Lekezz/wasn_node/docs/project-writeup-gdoc.md

Github: [https://github.com/Lekezz/wasn\_node.git](https://github.com/Lekezz/wasn_node.git)  
Presentation: [summer-presentation](https://docs.google.com/presentation/d/1hLClz3m2xzYzlfiDRH_qgMvEkAQSzI8XTW7FylySOrs/edit?usp=sharing)

# Acoustic source localization on an STM32 wireless sensor node

Status as of 2026-07-30.

## 1\. What this is

A wireless acoustic sensor node that listens with four microphones and reports the bearing of a sound source. A NUCLEO-L552ZE-Q (STM32L552, Cortex-M33 at 96 MHz) samples four PDM MEMS microphones in a 9.25 cm by 9.90 cm rectangle. When a clap happens, the node measures the small differences in arrival time between microphones and turns them into a direction. Capture, cross-correlation, and the direction fit all run on the microcontroller, with a matching Python implementation kept as the reference the firmware is checked against.

The result: on an 8-angle sweep in a real room, mean absolute bearing error was **1.11 degrees**, matching what simulation of the same array predicts. The remaining error appears to come from how accurately the source was marked on the floor, not from the array.

### Summary of key numbers

| Quantity | Value |
| :---- | :---- |
| Microphones | 4 x MP34DT01-M PDM, 16 kHz PCM via DFSDM |
| Array | 9.25 cm x 9.90 cm rectangle, ruler measured to about 0.5 mm |
| Aperture (diagonal) | 13.549 cm, which is 6.32 samples of delay |
| Condition number / rank | 1.070 / 2 (no blind directions) |
| Mean absolute bearing error | 1.11 deg over 39 claps, 8 angles |
| Worst single clap | 4.04 deg |
| Trial to trial spread | 0.99 deg mean |
| Simulation on same geometry | 0.99 deg mean |
| Firmware vs Python | delays 0.000 samples, bearing within 0.004 deg, 44 captures |
| Flash, release (-O2) | 55,712 bytes of 512 KB |
| Flash / RAM, debug build | 87,904 / 217,448 bytes (256 KB RAM) |
| CMSIS-DSP FFT tables | cut from 712 KB to 44 KB |

## 2\. Hardware and capture

Each MP34DT01-M is a PDM microphone: a one bit stream at a high rate that a digital filter turns into ordinary PCM. The STM32L5's DFSDM peripheral is built for this. One 2.4 MHz clock feeds all four microphones, and a sinc3 filter with oversampling ratio 150 gives 16 kHz, 16 bit audio per channel.

**The two-wire trick:**  
The MP34DT01-M has a SEL pin choosing which half of the clock cycle it drives its data line on: SEL to ground drives while the clock is high, SEL to 3V3 while it is low. Two microphones share one data wire without colliding, so four microphones need only two data pins. That matters because the DFSDM here has exactly four channels and Nucleo pin routing is limited.

**Sample alignment.**:  
GCC-PHAT measures delays to a fraction of a sample, so one sample of channel misalignment would be a large fraction of the array's whole aperture. Filters 1, 2 and 3 are armed with a sync trigger and filter 0 is started last, so all four begin converting on the same clock edge. The four DMA buffers are then handled as one synchronized frame: the code acts only once all four transfer flags of a phase are up, and treats all four identically. No path exists by which one channel can advance a frame ahead of another.

**Clap triggering:**  
A button press arms the array, 4000 warm-up samples (0.25 s) are discarded so the microphones and filters settle, and then the first sample above a threshold becomes sample 0 of a stored one second, four channel recording. That recording is analysed either on the board or offline over UART.

## 3\. How the algorithms work

Two algorithms: one measures the delay between a pair of microphones, the other turns six such delays into a direction.

### 3.1 GCC-PHAT: measuring the delay between two microphones

**The problem:**  
Two microphones 9.25 cm apart hear the same clap at slightly different times. At 343 m/s that difference is at most 270 microseconds, which at 16 kHz is 4.3 samples. For bearing accuracy around a degree we need that delay to a small fraction of a sample. One sample corresponds to 2.14 cm of path difference, so integer sample resolution is too coarse on its own.

**Plain cross correlation, computed through the FFT:**  
The classical way to find a delay is cross correlation: slide one signal against the other and find the shift where they overlap best. Done directly this is O(n^2). Correlation in time is multiplication in frequency, so there is a shortcut: FFT both windows, multiply one by the complex conjugate of the other, inverse FFT. That is O(n log n), and for the 2048 sample window used here it is the difference between millions of operations and tens of thousands.

**Zero pad to twice the length:**  
The FFT computes circular correlation: it treats each window as wrapping from end back to start. A genuine peak near the edge of the buffer would wrap around and reappear at completely the wrong lag. Padding both windows with zeros out to at least twice their length makes the circular correlation equal the linear one over the lags we care about. The firmware uses `LOC_WINDOW_LEN = 2048` (256 samples before the onset, 1792 after) and `LOC_FFT_LEN = 2 * LOC_WINDOW_LEN = 4096` for exactly this reason. The Python does the same by asking numpy for `n = len(a) + len(b)`.

**The PHAT weighting:**  
This is what makes the method work in a real room. After forming the cross spectrum `R = A * conj(B)`, every frequency bin is divided by its own magnitude, so only phase survives: `R[k] = R[k] / (|R[k]| + 1e-12)`.

Phase is *when* and magnitude is *what*, and only *when* carries direction information. Practically, this flattens the spectrum. Without it, a loud narrow band, or a reflection that happens to reinforce one band, dominates the sum and smears or shifts the correlation peak. With it, every band votes equally on the delay and the peak stays sharp.

Dividing by magnitude also amplifies bins containing nothing but noise, since a nearly empty bin is scaled up to the same weight as one full of signal. PHAT works best on broadband impulsive sources where most bins genuinely carry the event. A clap is close to ideal; a narrowband hum or a quiet source would be much harder, and that is one of the main limits on generalising these results. The `1e-12` guard keeps a silent bin from dividing by zero and leaves it near zero, which is correct since it carries no timing.

Also each window has its mean subtracted before the FFT. DC is a large spike in the zero frequency bin, and PHAT would normalise that spike up to the same weight as everything else and let it dominate.

**Sub-sample interpolation:**  
The inverse FFT gives a correlation curve at integer intervals, but the true peak almost never lands on a sample. Both implementations fit a parabola through the peak bin and its two neighbours and take the vertex:  
  
`offset = 0.5 * (y0 - y2) / (y0 - 2*y1 + y2)`

with y0, y1, y2 the magnitudes at peak-1, peak and peak+1. The reported delay is `best_lag + offset`. Both skip the interpolation when the peak sits on the edge of the searched range, since there is no neighbour on one side, and both guard a near zero denominator. This step takes resolution from 2.14 cm to well under a centimetre. Without it, single degree accuracy on an array this small would be impossible.

**The physical search limit:**  
The delay between two microphones cannot exceed their spacing divided by the speed of sound: 4.31 samples for the 9.25 cm baseline, 6.32 for the 13.549 cm diagonal. `Geom_MaxTauSamples()` computes this per pair and the peak search runs only over lags inside that window plus a sample of margin. Anything outside is not a possible arrival and is discarded for free. In an echoey room this kills most spurious peaks, and it is the cheapest robustness measure in the pipeline.

### 3.2 The direction estimate

**Far field assumption:**  
If the source is far enough away compared to the array size, the arriving wavefront is effectively flat across the array. Distance then stops mattering and all that survives is the direction, a unit vector `u = (ux, uy)` pointing from the array toward the source.

For a plane wave, arrival times at microphones i and j satisfy

`t_j - t_i = ((pos_i - pos_j) . u) / c`

We basically  take the vector between the two microphones, project it onto the direction the sound comes from, and divide by the speed of sound. That projection is the extra distance the wave travels to reach the later microphone, and it is the shadow described above. A microphone further along `u` is closer to the source and hears the clap earlier.

Writing the dot product out makes clear what is actually being solved for:

`delay = [ (xi - xj) * ux + (yi - yj) * uy ] / c`

The microphone spacings `(xi - xj)` and `(yi - yj)` are known, because the array was measured with a ruler. The speed of sound is known. The delay was just measured by GCC-PHAT. So `ux` and `uy` are the only unknowns in the whole system, and every pair contributes one equation of the plain form `(number) * ux + (number) * uy = (number)`.

There are two unknowns and not three because the array is flat. A direction in three dimensions needs `uz` as well, and a planar array physically cannot supply it. That is the elevation limitation listed in section 8, seen from the algebra side.

**Six equations, two unknowns:**  
Four microphones give six unique pairs, so the system is 6 by 2, overdetermined by four equations. That redundancy is the point**.** Here is a trial across all six pairs, against what the geometry predicts for a source at exactly 135 degrees:

| Pair | Predicted (samples) | Measured (samples) |
| :---- | :---- | :---- |
| 0-1 | 3.05 | 2.970 |
| 0-2 | 3.27 | 3.144 |
| 0-3 | 6.32 | 6.165 |
| 1-2 | 0.21 | 0.191 |
| 1-3 | 3.27 | 3.146 |
| 2-3 | 3.05 | 3.062 |

Every pair is close but none is exact, which is what real measurements look like. If one pair's correlation peak is pulled onto the wrong lobe by a reflection, the other five outvote it and the direction barely moves. With only two pairs there would be nothing to contradict a corrupted one.

**Least squares method:**  
This is the line of best fit, applied to a direction instead of a line. Six pairs each vote for a direction and they disagree slightly, so the fit finds the single direction that disagrees least with all six at once: for each pair, take how far off it is, square it, sum the six, and minimise the total. Squaring makes large misses hurt disproportionately, so the answer avoids being badly wrong about any one pair, and it is also what makes the minimum solvable in closed form.

## 4\. Getting it onto the microcontroller

**The FFT table problem:**  
CMSIS-DSP ships tables for every FFT size it supports. Built that delivered is about 712 KB of tables on a chip with 512 KB of flash, so the project does not fit at all. The fix was a copy of only `arm_rfft_fast_f32` and its dependencies plus a `cmsis_dsp_config.h` naming only the three tables a 4096 point real FFT needs, taking the set to 44 KB. Details in `docs/CMSIS_DSP_SETUP.md`.  
**Where the memory actually is.**

| Item | Size |
| :---- | :---- |
| `recording[4][16000]` int16, one second four channels | 128,000 bytes |
| `dma_buf[4][2048]` int32 | 32,768 bytes |
| Those two together | about 96% of `.bss` |
| FFT working buffers in `.ram2` | 49,152 bytes |
| Debug flash (87,760 text \+ 144 data) | 87,904 bytes |
| Debug RAM | 217,448 bytes |
| Release flash at \-O2 | 55,712 bytes |

The three 16 KB FFT buffers live in `.ram2`, a separate 64 KB bank nothing else uses, because the main 192 KB bank is nearly full once the capture buffers are placed. They are marked NOLOAD so startup does not zero 48 KB that gets overwritten immediately.

**Where the time goes:**  
 Cycle level profiling using the Cortex-M33 DWT counter costs 932 bytes of flash and 40 bytes of RAM. Measured on hardware at 96 MHz:

| Stage | Cycles | Time | Share |
| :---- | :---- | :---- | :---- |
| `find_clap` | 8,677,046 | 90.4 ms | 22% |
| GCC-PHAT, all six pairs | 29,526,954 | 307.6 ms | 77% |
| Fit | 2,312 | 0.024 ms | 0% |
| **Total** | **38,206,623** | **398.0 ms** | **100%** |

Three things stand out. The least squares fit, which is the part that looks like the actual localization, is free: 2,312 cycles, four ten thousandths of the total. All the cost is in the signal processing that produces the six delays. GCC-PHAT dominates at 77%, which is 51.3 ms per pair, and that cost scales with the number of pairs rather than microphones. Dropping to three microphones would halve it, saving roughly 154 ms, about 39% of the total. 

One caveat that matters: this is the Debug build, compiled at \-O0. The Release build at \-O2 is 55,712 bytes and would be substantially faster, but it has not been profiled, so no speedup factor is claimed here. Treat 398 ms as an upper bound.

## 5\. Validating the port against the reference

The Python implementation came first and was verified in simulation: delay bias under 0.001 samples, angle error under 0.1 degrees on synthetic sources with known ground truth. The firmware is an independent implementation of the same math in C, using CMSIS-DSP rather than numpy, float32 rather than float64, hand rolled 2x2 normal equations rather than `lstsq`, and a histogram median rather than `np.median`.

`compare_board.py` runs both on the same recorded samples, field by field, across 44 captures. Every pair delay agrees to 0.000 samples, every bearing to within 0.004 degrees, and onset and transient peak indices are exact everywhere. That is a strong claim because the two implementations share no code, and because the Python side was independently verified against known ground truth in simulation. 

## 6\. Results from the angle sweep

8 angles at 45 degree spacing, 5 claps each, source 1.1 m from the array, array 2.1 m from the nearest wall. 39 claps passed the bench quality check and were kept.  


| Metric | Value |
| :---- | :---- |
| Mean absolute bearing error | 1.11 deg |
| Worst single clap | 4.04 deg |
| Mean trial to trial spread within an angle | 0.99 deg |
| Simulation, same geometry | 0.99 deg |

Reverberation was expected to cost several degrees over the simulation and did not. The hardware sits at the simulation's own accuracy floor, which was not the expected outcome and is the most encouraging result in the project.

**per-angle bias:**  
Per-angle mean errors run from **\-1.43 to \+0.17 degrees**, while the spread *within* each angle stays between **0.38 and 1.82 degrees**. If the array were the limit, error would scatter randomly within each angle. Instead, each angle has its own consistent offset shared by all five of its claps, which is the signature of a fixed setup error per angle: each mark was placed on the floor by hand, and every clap at that angle inherits its offset.

At 1.1 m, a 5 cm placement error is already 2.6 degrees, more than the entire measured mean. Working backwards, the marks must have been good to roughly 2 cm for the observed numbers to be possible. That is a bound on the marks, not a measurement of them, but it does establish that truth is at least as tight a constraint as the array. Repeatability is better than accuracy against the marks, so the array is probably better than 1.11 degrees and the current setup cannot prove it.

### 7\. Does the fourth microphone earn its place?

A paired comparison on the same 39 claps, dropping one channel in software and re-running the fit through the surviving triangle.

| Configuration | Mean abs error | Worst | Spread |
| :---- | :---- | :---- | :---- |
| 4 mic | 1.11 deg | 4.04 deg | 0.99 deg |
| 3 mic triangle | 1.76 deg | 7.70 deg | 0.86 deg |

  
Pooled over all four triangles and 39 claps (156 trial configurations), the paired change was **mean \+0.88 degrees, median \+0.11, worst single degradation \+7.70**.  
The gap between mean and median is the finding. The typical clap barely notices the missing microphone; a minority collapse and drag the average. Each triangle is worst along the diagonal that does not pass through the microphone it dropped, and predicted bad angles matched observed ones.

This can be explained by geometry. Spare equations over the 2 unknowns drop from 4 to 1 and the error correction of the other two pairs is degraded.

The memory savings justify it. A genuine three-microphone node, with the DFSDM channel removed, saves about  40Kb bytes of RAM. Compute overhead also scales: pairs go from 6 to 3, halving the dominant stage.

## 8\. What is not done

The single node pipeline works end to end and is validated on hardware. 

- **One room:** Every number in section 6 is from a single session in one room. Nothing tests whether 1.11 degrees survives a different environment, reverberation time, or noise floor.   
- **The array is planar, so it gives bearing in the plane only:** A source above the plane is indistinguishable from its mirror below. Elevation needs a non-planar layout such as a tetrahedron.   
- **Single node, so bearing only, not position:** Crossing bearings from two nodes gives a position fix, but that needs inter-node time synchronization, which is its own hard problem and is not started.  
- **Claps only:** A clap is the easiest possible source, broadband and impulsive, which is exactly what PHAT weighting and the trigger and window design assume. Speech or machinery would need rethinking at the trigger, the window, and probably the weighting.

## 

[image1]: <>

[image2]: <>

[image3]: <>
