Lekezz/wasn_node/mic_sims_files/captures/2026-07-29-sweep/notes.txt

session 2026-07-29-sweep
========================

[2026-07-29 17:30] port COM4, 16000 Hz, 4 mics, geometry 9.25x9.9-measured, angles 0,45,90,135,180,225,270,315, 5 trial(s) each
    wall 2.1 m, clap 1.1 m
