Lekezz/wasn_node/mic_test/Core/Src/main.c

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
/* Includes ------------------------------------------------------------------*/
#include "main.h"

/* USER CODE BEGIN Includes */
#include "capture.h"
#include "localize.h"
/* USER CODE END Includes */

/* USER CODE BEGIN PD */
/* Capture configuration and buffers now live in capture.c / capture.h. */
/* USER CODE END PD */


COM_InitTypeDef BspCOMInit;
__IO uint32_t BspButtonState = BUTTON_RELEASED;
DFSDM_Filter_HandleTypeDef hdfsdm1_filter0;
DFSDM_Filter_HandleTypeDef hdfsdm1_filter1;
DFSDM_Filter_HandleTypeDef hdfsdm1_filter2;
DFSDM_Filter_HandleTypeDef hdfsdm1_filter3;
DFSDM_Channel_HandleTypeDef hdfsdm1_channel0;
DFSDM_Channel_HandleTypeDef hdfsdm1_channel1;
DFSDM_Channel_HandleTypeDef hdfsdm1_channel2;
DFSDM_Channel_HandleTypeDef hdfsdm1_channel3;
DMA_HandleTypeDef hdma_dfsdm1_flt0;
DMA_HandleTypeDef hdma_dfsdm1_flt1;
DMA_HandleTypeDef hdma_dfsdm1_flt3;
DMA_HandleTypeDef hdma_dfsdm1_flt2;

/* USER CODE BEGIN PV */
/* Capture buffers and state now live in capture.c (file-private). */
/* USER CODE END PV */

void SystemClock_Config(void);
static void MX_GPIO_Init(void);
static void MX_DMA_Init(void);
static void MX_ICACHE_Init(void);
static void MX_DFSDM1_Init(void);
/* USER CODE BEGIN 0 */
/* Capture helpers, DMA callbacks, and state machine now live in capture.c. */
/* USER CODE END 0 */

/**
  * @brief  The application entry point.
  * @retval int
  */
int main(void)
{

  /* MCU Configuration--------------------------------------------------------*/

  /* Reset of all peripherals, Initializes the Flash interface and the Systick. */
  HAL_Init();

  /* Configure the system clock */
  SystemClock_Config();

  /* Initialize all configured peripherals */
  MX_GPIO_Init();
  MX_DMA_Init();
  MX_ICACHE_Init();
  MX_DFSDM1_Init();
  /* USER CODE BEGIN 2 */

  /* Force filters 1-3 onto the sync trigger so they start in lockstep when
     filter0 starts. CubeMX generates SW_TRIGGER for all four; re-init the
     three slaves here so this holds even after a future regeneration. */
  hdfsdm1_filter1.Init.RegularParam.Trigger = DFSDM_FILTER_SYNC_TRIGGER;
  hdfsdm1_filter2.Init.RegularParam.Trigger = DFSDM_FILTER_SYNC_TRIGGER;
  hdfsdm1_filter3.Init.RegularParam.Trigger = DFSDM_FILTER_SYNC_TRIGGER;
  if (HAL_DFSDM_FilterInit(&hdfsdm1_filter1) != HAL_OK) Error_Handler();
  if (HAL_DFSDM_FilterInit(&hdfsdm1_filter2) != HAL_OK) Error_Handler();
  if (HAL_DFSDM_FilterInit(&hdfsdm1_filter3) != HAL_OK) Error_Handler();

  /* USER CODE END 2 */

  /* Initialize leds */
  BSP_LED_Init(LED_GREEN);
  BSP_LED_Init(LED_BLUE);
  BSP_LED_Init(LED_RED);

  /* Initialize USER push-button, will be used to trigger an interrupt each time it's pressed.*/
  BSP_PB_Init(BUTTON_USER, BUTTON_MODE_EXTI);

  /* Initialize COM1 port (115200, 8 bits (7-bit data + 1 stop bit), no parity */
  BspCOMInit.BaudRate   = 115200;
  BspCOMInit.WordLength = COM_WORDLENGTH_8B;
  BspCOMInit.StopBits   = COM_STOPBITS_1;
  BspCOMInit.Parity     = COM_PARITY_NONE;
  BspCOMInit.HwFlowCtl  = COM_HWCONTROL_NONE;
  if (BSP_COM_Init(COM1, &BspCOMInit) != BSP_ERROR_NONE)
  {
    Error_Handler();
  }

  /* USER CODE BEGIN BSP */

  /* -- Sample board code to send message over COM1 port ---- */
  printf("Welcome to STM32 world !\n\r");

  /* Prepare the on-board localizer: sets up the FFT and validates the active
     array geometry. Done once here rather than lazily on the first capture so
     a bad configuration is reported at boot, not eleven seconds after a clap. */
  if (!Localize_Init())
  {
    printf("WARNING: localizer failed to initialise. Captures will still be "
           "dumped, but no bearing will be computed.\r\n");
  }

  /* USER CODE END BSP */

  /* Infinite loop */
  /* USER CODE BEGIN WHILE */
  while (1)
  {
    /* IDLE: watch for the button. BspButtonState is set to BUTTON_PRESSED by
       the button's own interrupt (EXTI13 -> BSP_PB_Callback). A press arms a
       capture; Capture_Arm ignores it if one is already running. */
    if (BspButtonState == BUTTON_PRESSED)
    {
      BspButtonState = BUTTON_RELEASED;   /* consume the press so it fires once */
      Capture_Arm();
    }

    /* Run the capture state machine: drain the DMA frames, watch for the
       clap, and once a full second is banked, dump it over UART. Does
       nothing until armed. See capture.c. */
    Capture_Poll();

    /* A capture just finished and its raw audio is already on the wire.
       Localize it and print the bearing after the dump, so catch_audio4.py
       gets a clean WAV4 payload and the report lands in the terminal behind
       it. Takes a few tens of milliseconds; nothing else is time critical
       here because the array is idle until the next button press. */
    if (Capture_TakeResult())
    {
      static const int16_t *chans[4];
      for (int m = 0; m < 4; m++) chans[m] = Capture_Channel(m);

      static loc_result_t result;
      Localize_Run(chans, Capture_Length(), &result);
      Localize_Report(&result);
    }
    /* USER CODE END WHILE */

    /* USER CODE BEGIN 3 */
  }
  /* USER CODE END 3 */
}

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
/* USER CODE BEGIN 4 */
/* The DFSDM DMA callbacks now live in capture.c (they override the HAL weak
   defaults from there just the same). */
/* USER CODE END 4 */

/**
  * @brief BSP Push Button callback
  * @param Button Specifies the pressed button
  * @retval None
  */
void BSP_PB_Callback(Button_TypeDef Button)
{
  if (Button == BUTTON_USER)
  {
    BspButtonState = BUTTON_PRESSED;
  }
}

/**
  * @brief  This function is executed in case of error occurrence.
  * @retval None
  */
void Error_Handler(void)
{
  /* USER CODE BEGIN Error_Handler_Debug */
  /* User can add his own implementation to report the HAL error return state */
  __disable_irq();
  while (1)
  {
  }
  /* USER CODE END Error_Handler_Debug */
}
#ifdef USE_FULL_ASSERT
/**
  * @brief  Reports the name of the source file and the source line number
  *         where the assert_param error has occurred.
  * @param  file: pointer to the source file name
  * @param  line: assert_param error line source number
  * @retval None
  */
void assert_failed(uint8_t *file, uint32_t line)
{
  /* USER CODE BEGIN 6 */
  /* User can add his own implementation to report the file name and line number,
     ex: printf("Wrong parameters value: file %s on line %d\r\n", file, line) */
  /* USER CODE END 6 */
}
#endif /* USE_FULL_ASSERT */
