Lekezz/wasn_node/mic_test/mic_test.ioc

Mcu.UserName=STM32L552ZETxQ
PB1.Signal=S_DATAIN0DFSDM1
PE7.Signal=S_DATAIN2DFSDM1
PF10.Signal=S_CKOUTDFSDM1
PG7.Signal=LPUART1_TX
PG8.Signal=LPUART1_RX
