Lekezz/wasn_node/(commit log)

2026-07-20 Single mic capture working: DFSDM + DMA recording, UART dump, WAV capture script, localization simulation
2026-07-20 Initialize README with project overview and instructions
    Added detailed project description, current state, repo layout, hardware setup, usage instructions, and next milestones.
2026-07-20 CubeMX: set DFSDM channel 3 RightBitShift to 0x07
    Channel 3 (mic3, PB1 falling edge) was generated with RightBitShift 0x00
    while channels 0-2 use 0x07. That made mic3 roughly 2^7 louder than the
    other three before any application scaling. Match it to the other
    channels so all four mics share the same gain.
    Regenerated from the .ioc via CubeMX. Verified git diff touches only the
    channel 3 RightBitShift value and stm32l5xx_hal_msp.c DMA settings did
    not regress (still DMA_CIRCULAR, WORD/WORD on all four DFSDM channels).
2026-07-20 Wire 4-mic DFSDM recording state machine into main.c
    Replace the single-mic demo user code with the four-mic recorder. On a
    button press all four filters are started in sync order (slaves 1,2,3
    armed first, filter0 last so its start releases the group sample-aligned),
    each mic's circular DMA buffer is drained per-half via a filter->mic map,
    and once every channel has banked TOTAL_SAMPLES the four recordings are
    dumped over UART behind a "WAV4" + per-channel length header in mic order.
    RECORD_SECS drops from 4 to 1 to fit the 256 KB RAM budget (four int16
    channels at 16 kHz = 128 KB, plus 32 KB of DMA buffers). At 32000 bytes
    per channel each fits a single HAL_UART_Transmit (uint16_t size li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
    [main.c]
2026-07-20 Add .gitignore; stop tracking Debug build output
    No .gitignore existed, so 129 STM32CubeIDE build artifacts under Debug/
    were tracked and churned on every compile. Remove them from the index
    (files stay on disk, rebuilt by CubeIDE) and ignore Debug/, Release/,
    Python __pycache__, and the regenerated 4-mic capture outputs going
    forward.
2026-07-22 Add warm-up discard and the 4-mic sync check tooling
    Firmware: discard WARMUP_SAMPLES (4000, 0.25 s) per mic before storing starts. The notes said to trim the first second of mic turn-on and DFSDM settling, but RECORD_SECS is 1 so there was nothing left to trim. Every mic drops the same count from its own stream, so channel alignment is unaffected. All inside USER CODE fences.
    New check_sync.py: per-channel health, clap onset from the summed envelope, and each channel's GCC-PHAT lag against mic0 with a 5 sample tolerance. Imports gcc_phat from localization_sim.py so the bring-up test and the reference implementation cannot drift apart. Smoke tested on a synthetic capture with a 1-sample-per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
    [main.c]
2026-07-22 check_sync.py: measure AC, and report DC drift around the transient
    The health report computed rms without removing DC, so it was mostly measuring the DC excursion a loud clap leaves behind. That tail is larger on whichever mics got the louder clap, which made four well-matched channels look like a 2.2x gain split and sent the first analysis chasing a nonexistent right-bit-shift bug. All four channels are in fact configured identically (verified in both the .ioc and the generated MX_DFSDM1_Init) and match within 1.34x on room noise.
    Now: rms and peak are computed AC-coupled, a DC drift table shows before vs after the transient so clap recovery is distinguishable from a real per-channel offs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
2026-07-22 Keep the first clean 4-mic capture as a reference
    Capture outputs are gitignored because they regenerate every run, so this one is archived under captures/2026-07-22-inline-clap/ with a name that does not match those patterns. Stored as the .npy only; the four WAVs are derivable from it.
    Worth keeping because the delays are physically consistent, not merely inside tolerance: lags against mic0 of 0.000, -0.481, -1.354, -1.801 samples are monotonic across the in-line fixture and linear in mic position to a max residual of 0.131 samples. Nothing in the firmware forces that linearity, so it is end-to-end evidence that the sync start, DMA drain, filter-to-mic map, and serial protocol are all cor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
2026-07-22 Add geometry comparison and real-capture localization
    The 10 cm square the simulation was validated against does not fit a single full-size breadboard (about 2.8 cm across the usable rows), so compare_geometries.py scores the layouts that do fit, running each through the reference estimator rather than guessing. Result: a 2.8 x 10 cm rectangle keeps the square's median accuracy (1.06 vs 1.01 deg) and stays non-collinear (rank 2, condition number 3.6), while shrinking to a 2.5 cm square that fits both axes would cost 6.33 deg mean. The rectangle's weakness is four narrow blind cones about 30 deg off the long axis where error reaches 8 deg; elsewhere it is under 2 deg.
    localize_capture.py clo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
2026-07-22 Move geometry into a registry; active layout 9.25 x 10 cm
    Two breadboards glued together give about 9.25 cm of width, so a near-square fits again and the single-board 2.8 x 10 cm rectangle is superseded. That layout had four blind cones about 30 deg off the long axis (p90 7.87 deg); the new 9.25 x 10 cm has none (condition number 1.08, worst direction 1.69 deg) and slightly beats the original 10 cm square.
    Geometry moved out of the scripts into array_geometry.py: named layouts, an ACTIVE selection, per-layout measured flags, and describe() for rank/condition/aperture. Trying a new layout is now a one-line edit that compare_geometries.py picks up automatically. localize_capture.py derives it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
2026-07-23 Set active layout to the built 9.25 x 9.9 cm measured array
    The array is built and measured: 9.25 cm wide, 9.9 cm tall, mics on calipers. Added it as 9.25x9.9-measured (measured=True) and made it ACTIVE. Dimensions are two named constants (BUILT_WIDTH_X, BUILT_HEIGHT_Y) so re-measuring is a two-number edit.
    Corrected the corner-to-mic mapping to match the physical build: mic0 top-left, mic1 top-right, mic2 bottom-left, mic3 bottom-right. The old rect() ordering had mic0/mic1 swapped, which would have reflected every bearing. Verified end to end: 9 known bearings recovered at mean 0.82 deg, worst 1.62 deg, no blind cones.
2026-07-23 Archive first ground-truthed spaced-array capture (error +3.3 deg)
    First clap on the real 9.25 x 9.9 cm array with a known true angle. True 90 deg, estimated 93.3, error +3.3 deg: the project's first real accuracy number, in the expected several-degree real-world band against the sim's 0.8 deg ceiling. Plane-wave residual 0.368 samples confirms the build and mic mapping are correct. Kept as .npy plus README; the four WAVs are derivable.
2026-07-23 catch_audio4.py: add --tag to name captures during an angle sweep
    The script overwrote capture.npy every run, so a sweep of angles kept only the last. --tag PREFIX writes PREFIX_mic0.wav.. and PREFIX_capture.npy (e.g. --tag angle090), and prints the localize command to run next. Switched argument handling to argparse; the bare positional port form (python catch_audio4.py COM7) still works, and without --tag the filenames are unchanged.
2026-07-23 Add estimated-vs-true bearing validation plot (milestone 5 deliverable)
    plot_validation.py auto-discovers angle<NNN>_capture.npy files (what catch_audio4.py --tag angleNNN writes), localizes each with the active geometry, and plots estimated vs true plus error vs true, saved to validation_plot.png. Extra points can be passed as PATH:ANGLE, which is how the already-archived 90 deg capture is included without renaming it. A simulation reference curve is always drawn and clearly labelled as the clean-room ceiling, not measured data. Gitignored the sweep outputs (tagged captures, WAVs, PNG) since they regenerate from the board.
2026-07-23 Support multiple trials per angle in capture and validation plot
    catch_audio4.py --trials N takes N recordings in a row at one angle, each waiting for its own button press, named angle<NNN>_trial<K>_capture.npy. Trial numbers auto-continue past files already saved for the tag, so rerunning the command adds more instead of overwriting. Prints a peak-level quality hint per trial so a clipped or too-quiet clap is caught immediately, not at plot time.
    plot_validation.py groups trials by true angle and reports per-angle mean error, trial-to-trial spread (std), and mean/max abs error, plus overall accuracy and precision. The plot shows every trial faintly with a bold per-angle mean and +/- 1 std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
2026-07-24 Add clap-triggered capture, move capture logic into capture.c/.h
    Recording no longer needs the clap timed against a fixed window. Button
    press arms the array (green LED), the firmware discards warm-up, then
    listens indefinitely; the first frame with any sample past TRIGGER_LEVEL
    becomes sample 0 of the stored second. Wire format (WAV4) is unchanged,
    so catch_audio4.py and check_sync.py are untouched.
    The four channels are processed as one synchronized frame (act only when
    all four DMA flags of a phase are up, treat all four identically), so the
    clap can never start one channel a frame ahead of another. Channel
    alignment, which GCC-PHAT depends on, stays exact. Warm-up is now a single
    global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
    [main.c]
2026-07-24 Derive sync tolerance from geometry, remove DC before transient detection
    Two analysis bugs found while validating the first 0 degree capture on the
    built 9.25 x 9.9 cm array. Both would have misreported results across the
    angle sweep.
    check_sync.py hardcoded SYNC_TOLERANCE = 5.0 samples, sized for the retired
    in-line fixture whose aperture was about 3 samples. The built array has a
    13.5 cm diagonal, which is 6.32 samples, so a clap near a diagonal would
    have printed FAIL on perfectly synced hardware. The tolerance is now the
    ACTIVE layout aperture plus 2.0 samples of slack, so it tracks the geometry
    the same way localize_capture.py derives POOR_CONES from the condition
    number. The script p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
2026-07-24 Fix wrong mic labels on the bearing convention printout
    The +x axis holds mic1 and mic3, but the printout said 'the mic0 / mic3
    end'. mic0 sits at x -4.62 cm, the opposite edge. Anyone orienting a
    sweep from that line would have clapped from the wrong side and taken a
    systematic 180 degree error into every angle.
    Names the right-hand mic1 / mic3 edge, and gives 90 deg as a second
    reference point so the sense of rotation is unambiguous.
2026-07-27 After adding CMSIS-DSP: vendor the FFT instead of generating it
    Counterpart to 3a141f9. The on-board localizer needs a 4096-point real
    FFT; this brings in arm_rfft_fast_f32 and its dependencies.
    Not via CubeMX, deliberately. The only locally available pack carrying
    CMSIS-DSP is FP-SNS-STAIOTCFT, an AI/IoT function pack, and selecting its
    CMSIS DSP entries also switches on a USB Device CDC stack, a USB core, an
    AI_INERTIAL application, PnPL and a pre-processing library. All of that
    would land in the project and compete for the RAM the capture buffers
    need. Going through CubeMX also means a regeneration, and CLAUDE.md
    records that regeneration has silently reverted DFSDM DMA settings twice;
    t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
2026-07-27 Fix blank floats in the board report, lower TRIGGER_LEVEL to 1000
    First hardware run of the localizer exposed two problems.
    Every float in the board's report printed as nothing: "BEARING deg" and
    six blank pair delays, while every integer field printed correctly. That
    is the fingerprint of --specs=nano.specs, whose printf omits floating
    point unless the link also pulls in -u _printf_float. Rather than enable
    that linker flag, which is IDE state a CubeMX regeneration resets and
    costs about 10 KB of flash, Localize_Report now formats floats with
    integer arithmetic through a new f2s() helper. No %f remains anywhere in
    the project, so this cannot regress from a build setting. The conversion
    wa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
    [localize.c]
2026-07-28 Add board-vs-Python comparison, refresh README, start writeup and deck
    compare_board.py is the acceptance test the CMSIS-DSP port was missing.
    catch_audio4.py already saved the board's report as trial<K>_bearing.txt
    next to trial<K>.npy, so every trial carried two independent answers to the
    same question, but nothing read them back: the port was being judged by eye
    against a terminal scroll. This compares them field by field and gives a
    pass or fail, with delays required to agree within 0.05 samples and the
    bearing within 0.5 deg. Those tolerances sit far above both float32 drift
    and the report's own print rounding, and far below the array's measurement
    error, where 1 mm of position is about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
2026-07-28 Generate the summer presentation deck and its figures
    docs/summer-presentation.pptx, 21 slides (16 main plus a backup section),
    built by docs/make_presentation.py from the content in
    presentation-outline.md. Speaker notes are attached to every slide.
    A script rather than a hand-built deck, because the numbers on these slides
    are still moving: the 315 degree trials are unexplained and the
    board-versus-reference comparison has no result yet. Regenerating is one
    command, so a slide cannot quietly keep a stale figure. It overwrites the
    pptx, which is called out in the docstring.
    Five figures drawn here too, in the same palette: the TDOA geometry, the
    built array with its bearing convention, th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
2026-07-28 Remove the presentation deck from the repo
    Kept local while the figures are reworked: the descriptive text is baked
    into the images, which makes it uneditable in PowerPoint. The generator
    script and figures stay for now.
    The pptx is untracked and ignored, not deleted. It is still at
    docs/summer-presentation.pptx locally, and removing one line from
    .gitignore publishes it again.
2026-07-28 Remove all presentation material from the repo
    The deck, its five figures, the generator script and the slide outline are
    untracked and ignored while the figures are reworked to keep their
    descriptive text editable in PowerPoint rather than baked into the images.
    Nothing is deleted: every file is still in docs/ locally. GitHub keeps the
    code, the captures and docs/summer-writeup-2026.md, which is the written
    writeup rather than presentation material.
2026-07-29 Handle --help, and ask for 1.5 m of source distance
    trial_quality.py and compare_board.py both treated --help as a file path
    and died inside numpy. Both now print usage and exit 0.
    The session runner asked for the source 1 m or more out. Two reasons that
    is not far enough, both learned from the 2026-07-27 captures, which were
    taken at 40 cm. The plane-wave model the estimator assumes needs roughly
    2*D^2/lambda of distance, which for this 13.55 cm aperture is 0.86 m at
    8 kHz, and a clap has real energy that high, so at 40 cm the top of the
    band was in the near field and arriving curved. A curved wavefront fits no
    single direction, which is what the raised triangle residuals on those
    trials l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
2026-07-29 Bring the README up to date with the current tooling and status
    The repo layout still listed the presentation outline, the deck and its
    generator under docs/, none of which are in the repo any more, and did not
    list the four capture-tooling scripts that are. Both fixed, and every path
    the README names is now a file that exists and is tracked.
    Usage now leads with run_session.py, since a guided session is how recording
    is actually done. It also states the two things that are easy to get wrong
    and expensive when you do: start the script before pressing the button
    because only one process can hold the COM port, and clap from 1.5 m or more
    because closer than about 0.9 m puts the top of a clap'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
2026-07-29 Derive the peak/noise tolerance; the CMSIS-DSP port passes
    First capture on the reflashed board. The floats print, and every field that
    matters matches the Python reference on identical samples: all six pair
    delays to 0.000 samples, the triangle residual to 0.000, the bearing to
    0.002 deg (0.340 board against 0.338 reference), and onset, transient peak
    and analysis window exactly. That is the embedded port validated, and the
    last blocking item on milestone 7.
    One field failed, and it was the test that was wrong rather than the
    firmware. peak/noise came back 194.950 against 199.434, a 4.484 gap that my
    flat 2 percent tolerance rejected.
    The firmware does not compute a true median. It bins t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
2026-07-30 Full 8-angle sweep: 1.11 deg mean error, and the port passes on all 44
    The deliverable. Eight angles at 45 degree spacing, five claps each, source
    1.5 m out, array 2.1 m from the nearest wall. 39 good claps give a mean
    absolute bearing error of 1.11 deg, worst 4.04 deg, mean trial-to-trial
    spread 0.99 deg.
    For scale, the same estimator on synthetic claps through the same geometry,
    with no reverberation and exact geometry handed to it, gives mean 0.99 deg.
    The real array is at the simulation's own accuracy floor. Reverberation was
    expected to cost several degrees and it did not.
    The per-angle means carry a pattern worth recording: within one angle the
    spread is small (0.38 to 1.82 deg) but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
2026-07-30 Ruler, not calipers: correct how the array was measured
    The array dimensions were measured with a ruler. Every doc and comment said
    calipers, which was wrong, and it matters because every bearing this project
    computes comes out of those two numbers.
    Where the passages carried a lesson, the lesson is kept and only the
    instrument changed. The point of most of them was to measure the mic PORTS
    rather than the header pins, since the port is offset from the pins on a
    breakout board, and that is still true and still the more important half:
    port to port with a ruler beats pin to pin with calipers, because the pin
    offset is several millimetres of error in a known wrong direction while
    ruler readin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
2026-07-30 Firmware comments: the array was measured with a ruler, not calipers
    Comment-only, so the compiled output is unchanged and no reflash is needed.
    The two printed strings that still say "calipered" are left alone on
    purpose: array_geometry.c's layout note and localize.c's "this layout is
    nominal, not calipered" warning. Changing a string literal changes the
    binary, and the board was validated against the current image on 2026-07-29
    across 44 captures. Neither string is worth breaking that correspondence
    for, and the localize.c one only prints when a layout is NOT measured, which
    never happens for this array. Both will pick up the wording at the next
    natural rebuild.
2026-07-30 Firmware: mic-count build switch and DWT cycle profiling
    Two compile-time switches in loc_config.h, both off-by-default in the
    sense that the 4-mic non-profiled build is unchanged.
    LOC_MIC_COUNT (4 or 3) lets the 3-mic triangle and the 4-mic square come
    from one source tree instead of a branch kept in step by hand.
    array_geometry.c switches its pair table and its layout rows on the same
    symbol; every loop already ran to LOC_NUM_MICS or LOC_NUM_PAIRS. Verified
    the 4-mic build is byte-identical to before the switch existed:
    87,760 text / 144 data / 217,448 bss either way.
    LOC_PROFILE_ENABLE adds Cortex-M33 DWT cycle counting around find_clap,
    the GCC-PHAT pair loop and the fit. Costs 932 byt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
2026-07-30 Two studies: does the fourth mic earn its place, and how close is too close
    compare_mic_count.py re-analyses the 39 sweep claps as 4-mic and as each
    3-mic triangle. Paired comparison on identical acoustic events, so no
    session-to-session confound: a triangle is just a subset of the same
    samples. Reproduces the 4-mic deliverable exactly (1.11 / 4.04 / 0.99) as
    its own correctness check and exits 1 if that ever stops being true.
    Result: keep the fourth mic. Triangles score 1.76 to 2.19 mean, with
    worst-clap error up to 17.64 against 4.04. The paired delta is mean +0.88
    deg but median only +0.11, and that gap is the finding: the typical clap
    barely notices the missing mic, a minority collapse,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
2026-07-30 Docs: cut retired work, correct the sweep distance and the 315 explanation
    Cleanup. Removed the retired in-line bring-up fixture and the superseded
    geometries, the early capture sessions as narrated results, and the
    firmware debugging history. Kept the lessons those carried where they are
    load-bearing: wall clearance stays in the bench checklist with the
    image-source arithmetic, and f2s stays as a design decision rather than a
    war story. steps-forward.md was badly stale, still saying the port was
    partly validated and that f5c3d78 had never been flashed, so it is
    rewritten as a handoff.
    Two factual corrections.
    The sweep source distance was 1.1 m, not 1.5 m. captures/2026-07-29-sweep
    /notes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
2026-07-30 Project writeup, and a photo of the built array
    docs/project-writeup-gdoc.md is a standalone writeup for sharing outside
    the repo, written to be pasted into Google Docs. Its longest section
    explains how the algorithms actually work: GCC-PHAT from cross correlation
    through the FFT shortcut, why the windows are zero padded to twice their
    length, what the PHAT weighting buys in a real room and what it costs,
    sub-sample parabolic interpolation, and the physical search limit. Then
    the direction estimate: the plane-wave model, why six pairs over two
    unknowns is the point rather than an accident, and why the condition
    number matters.
    Includes the stage timings measured on hardware with the DWT cou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
2026-07-31 Writeup: build up the direction estimate before formalising it
    Section 3.2 assumed the reader was already comfortable with matrices and
    least squares, which meant the one genuinely interesting idea in it was
    buried under notation. Rewritten to arrive at the same place from the
    physics.
    Added, in order: what a single pair actually measures, framed as the
    shadow of the source direction cast onto that pair's axis; why one pair
    can never be enough, since a zero delay means directly above or directly
    below and the pair cannot tell them apart; why a second pair running a
    different way fixes it, which is the real reason a collinear array fails;
    what ux and uy are, and that they are the only unknow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
2026-08-03 Trim the public repo to the result and the evidence for it
    The repo had grown to include the bench rig alongside the work. Cut back so
    a visitor sees the writeup, the deck, the simulation reference, and the
    analysis that produced the numbers.
    Everything removed here used --cached and is listed in .gitignore, so it all
    stays in the working tree. Nothing was deleted from disk. run_session.py in
    particular is still how a sweep gets recorded.
    docs/ is now exactly two files: project-writeup-gdoc.md and the presentation.
    The deck was previously gitignored while it was being reworked and is now
    published. summer-writeup-2026.md is superseded by the gdoc writeup;
    steps-forward.md and bench-checkli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
