Lekezz/wasn_node/setup.jpeg

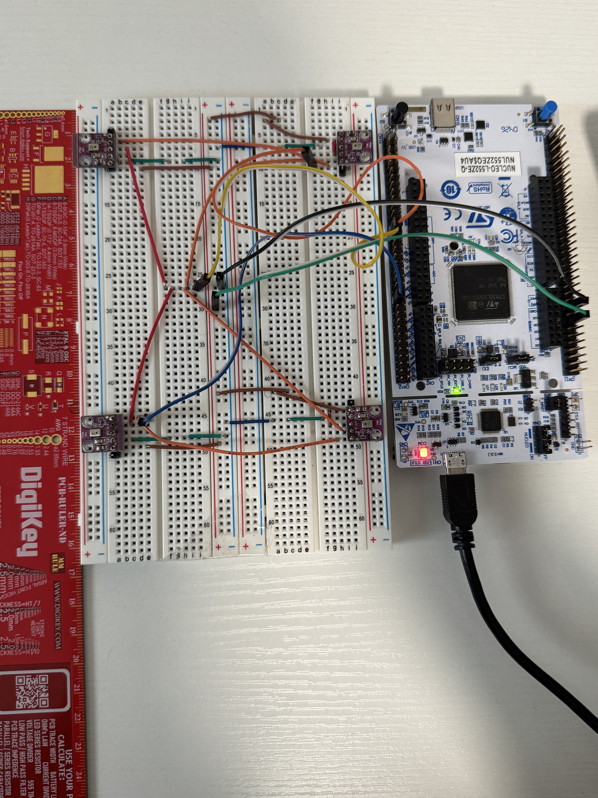
[picture p1: setup.jpeg]
setup.jpeg
